sandersonfsl/diffbot_ws/media/eletronics_and_schematic.png

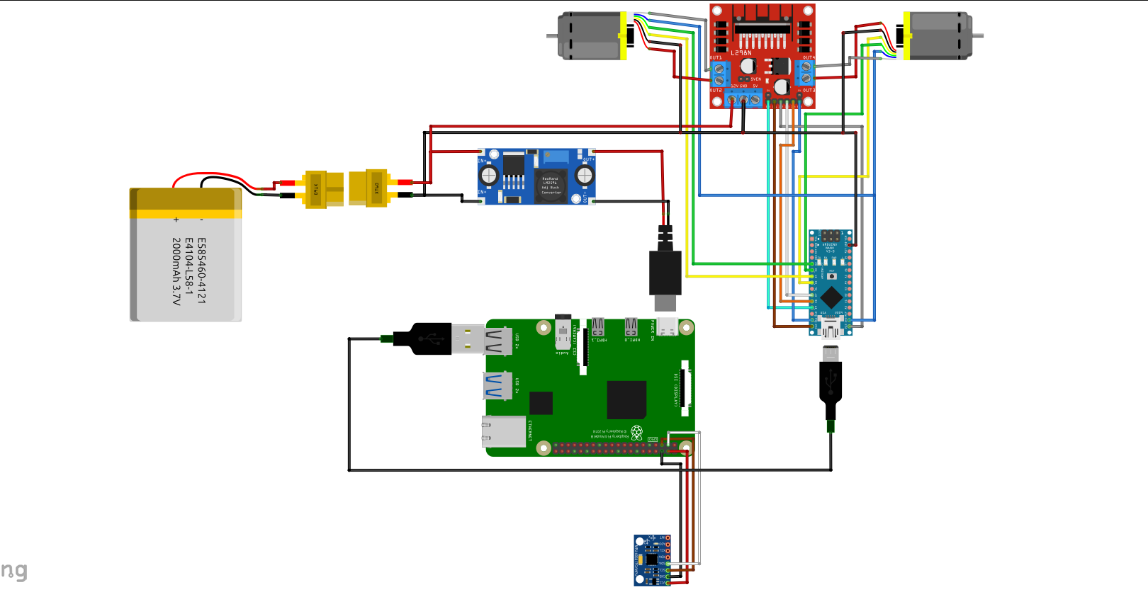
media/eletronics_and_schematic.png
