sandersonfsl/diffbot_ws/src/diffbot_description/meshes/laser_link.STL

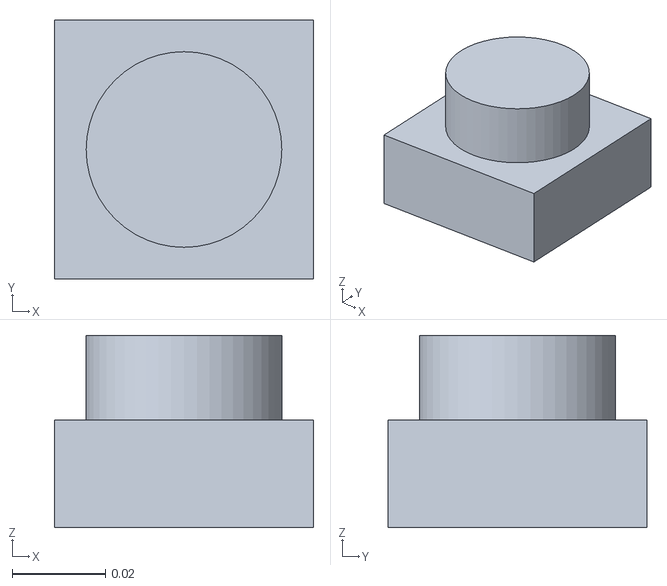
[picture p8: CAD file, 2026-09-09]
src/diffbot_description/meshes/laser_link.STL
0.0556 x 0.0556 x 0.0413
