sandersonfsl/diffbot_ws/src/diffbot_description/meshes/imu_link.STL

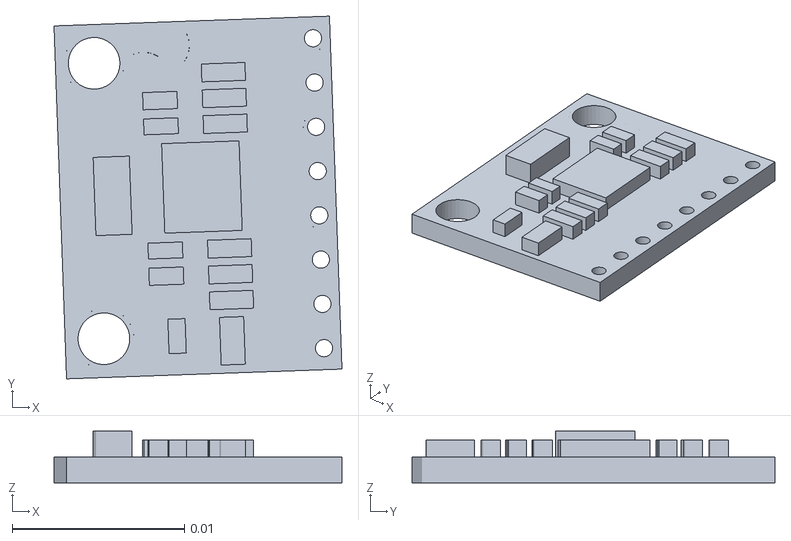
[picture p9: CAD file, 2026-08-24]
src/diffbot_description/meshes/imu_link.STL
0.0167 x 0.0211 x 0.003
