sandersonfsl/diffbot_ws/src/diffbot_description/meshes/caster_front_link.STL

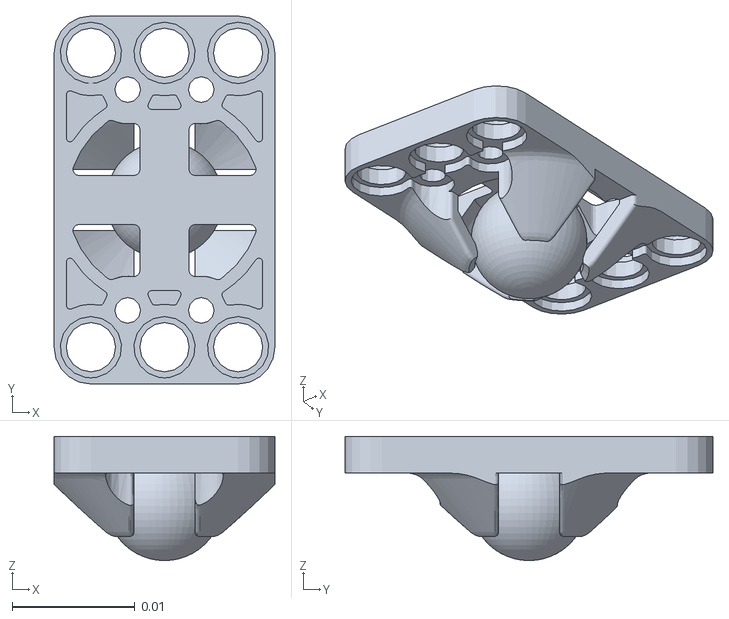
[picture p10: CAD file, 2026-08-19]
src/diffbot_description/meshes/caster_front_link.STL
0.018 x 0.03 x 0.0101
