sandersonfsl/diffbot_ws/src/diffbot_description/meshes/wheel_left_link.STL

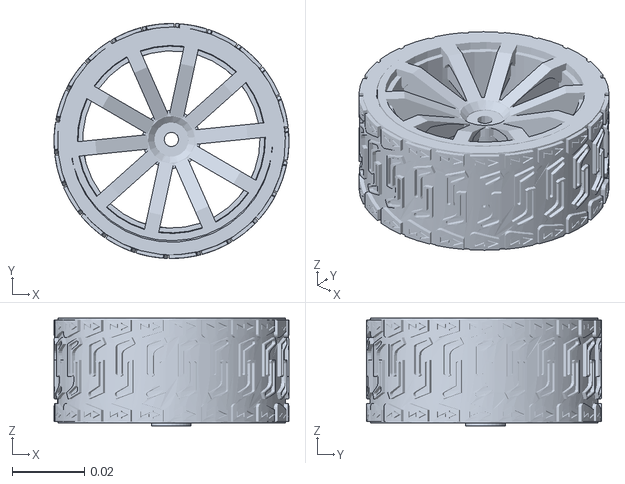
[picture p11: CAD file, 2026-08-19]
src/diffbot_description/meshes/wheel_left_link.STL
0.065 x 0.065 x 0.0298
