sandersonfsl/diffbot_ws/src/diffbot_description/meshes/base_link.STL

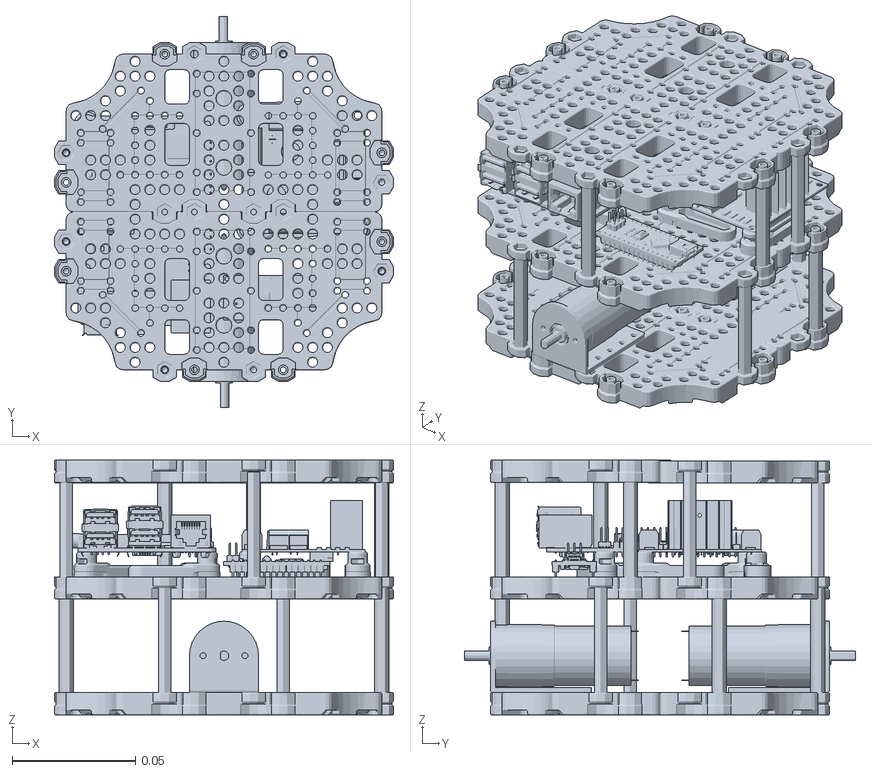
[picture p12: CAD file, 2026-08-13]
src/diffbot_description/meshes/base_link.STL
0.138 x 0.159 x 0.103
