sandersonfsl/diffbot_ws/(list of files, cad)

Other CAD files:
src/diffbot_description/meshes/caster_rear_link.STL
src/diffbot_description/meshes/wheel_right_link.STL
