sandersonfsl/diffbot_ws/docs/raspberry_pi_setup.md

# Raspberry Pi 5 (16GB) hardware setup

## OS

Ubuntu Server 24.04, installed directly (no desktop environment).

## SSH on a non-default port

SSH configured to listen on port `3333` instead of the default `22`.

## Networking — prioritize Wi-Fi over Ethernet

`/etc/netplan/50-cloud-init.yaml`, both interfaces configured with static IPs, Wi-Fi given a
lower (preferred) route metric than Ethernet so Wi-Fi wins whenever both are up:

```yaml
network:
  version: 2
  renderer: networkd
  ethernets:
    eth0:
      dhcp4: no
      addresses:
        - <YOUR_IP>/24
      routes:
        - to: default
          via: <YOUR_GATEWAY>
          metric: 100        # lower priority
      nameservers:
        addresses: [8.8.8.8, 1.1.1.1]
      optional: true
  wifis:
    wlan0:
      optional: true
      dhcp4: no
      addresses:
        - <YOUR_IP>/24
      routes:
        - to: default
          via: <YOUR_GATEWAY>
          metric: 50         # higher priority — Wi-Fi wins
      nameservers:
        addresses: [8.8.8.8, 1.1.1.1]
      access-points:
        "<YOUR_SSID>":
          password: "<YOUR_WIFI_PASSWORD>"
```

Apply with `sudo netplan apply`.

## Disable Wi-Fi power save (systemd service)

Wi-Fi power save causes dropped/laggy connections on a robot that needs a stable link for
teleop and ROS2 traffic. Disabled permanently via a oneshot systemd unit instead of a manual
`iw` call that wouldn't survive a reboot.

```sh
sudo apt update
sudo apt install iw
```

`/etc/systemd/system/wifi-powersave-off.service`:

```ini
[Unit]
Description=Disable WiFi power save
After=network-online.target
Wants=network-online.target

[Service]
Type=oneshot
ExecStart=/usr/sbin/iw dev wlan0 set power_save off
RemainAfterExit=true

[Install]
WantedBy=multi-user.target
```

```sh
sudo systemctl daemon-reload
sudo systemctl enable --now wifi-powersave-off.service
```

## Serial port permissions

Add the user to `dialout` so the Arduino's serial port doesn't need `sudo`:

```sh
sudo usermod -aG dialout $USER
```

Group membership only applies to new login sessions — log out/in (or `su - $USER`) to pick
it up without a full reboot.

## udev rules — stable serial device names (Arduino Nano, RPLIDAR C1)

Both the Nano and the RPLIDAR C1 show up as `/dev/ttyUSB*`, and which one gets
`ttyUSB0` vs `ttyUSB1` depends on USB enumeration order at boot — not safe to
hardcode. Identified each device's chip via:

```sh
udevadm info -a -n /dev/ttyUSB0 | grep -E "idVendor|idProduct|serial|product|manufacturer"
udevadm info -a -n /dev/ttyUSB1 | grep -E "idVendor|idProduct|serial|product|manufacturer"
```

Confirmed on this robot: Nano = CH340 clone (`1a86:7523`), RPLIDAR C1 = Silicon
Labs CP2102N (`10c4:ea60` — same chip/rule the `sllidar_ros2` package ships by
default). Different vendor:product pairs, so both rules coexist safely.

`/etc/udev/rules.d/99-arduino.rules`:

```
SUBSYSTEM=="tty", ATTRS{idVendor}=="1a86", ATTRS{idProduct}=="7523", MODE:="0666", SYMLINK+="arduino"
```

`/etc/udev/rules.d/99-rplidar.rules`:

```
SUBSYSTEM=="tty", ATTRS{idVendor}=="10c4", ATTRS{idProduct}=="ea60", MODE:="0666", SYMLINK+="rplidar"
```

```sh
sudo udevadm control --reload-rules
sudo udevadm trigger
ls -l /dev/arduino /dev/rplidar   # both should now point at the right ttyUSB*
```

`diffbot_description/urdf/diffbot_ros2_control.xacro` points at `/dev/arduino` for
this reason — don't revert it to a raw `ttyUSB0`/`ttyUSB1`.

## Bluetooth joystick (Logitech F710)

```sh
sudo apt update
sudo apt install bluez bluetooth
sudo systemctl enable --now bluetooth
```

Pair via `bluetoothctl`:

```
bluetoothctl
power on
agent on
default-agent
scan on
pair C6:F2:4D:3D:E1:CB
trust C6:F2:4D:3D:E1:CB
connect C6:F2:4D:3D:E1:CB
```

Verify the device shows up as an input device:

```sh
sudo apt install evtest
sudo evtest
```

If the connection is flaky/slow to reconnect, uncomment `FastConnectable = false` in
`/etc/bluetooth/main.conf`.

## udev rules — generic input devices

`/etc/udev/rules.d/81-event.rules`:

```
SUBSYSTEM=="input", KERNEL=="event*", GROUP="input", MODE="0660"
```

```sh
sudo udevadm control --reload-rules && sudo udevadm trigger
sudo usermod -aG input $USER   # new session needed to take effect
```

## udev rule — joystick device node

`/etc/udev/rules.d/99-joystick.rules`:

```
SUBSYSTEM=="input", KERNEL=="js*", GROUP="dialout", MODE="0666"
```

```sh
sudo udevadm control --reload-rules
sudo udevadm trigger
```

## Arduino firmware via PlatformIO (not the Arduino IDE)

Lets the Nano firmware be built/flashed from
the CLI, independent of the ROS 2 container, in its own project folder (kept separate from
the `diffbot_firmware` ROS2 package on purpose: one is the Nano-side sketch, the other is the
ROS2-side serial bridge — different build systems, different targets, no reason to couple them).

```sh
mkdir ~/platformio && cd ~/platformio
curl -fsSL -o get-platformio.py https://raw.githubusercontent.com/platformio/platformio-core-installer/master/get-platformio.py
sudo apt update && sudo apt install python3-venv
python3 get-platformio.py
```

Expose the CLI tools:

```sh
sudo mkdir -p /usr/local/bin
sudo ln -s ~/.platformio/penv/bin/platformio /usr/local/bin/platformio
sudo ln -s ~/.platformio/penv/bin/pio /usr/local/bin/pio
sudo ln -s ~/.platformio/penv/bin/piodebuggdb /usr/local/bin/piodebuggdb
pio --version   # sanity check
```

udev rules for PlatformIO's own upload tooling:

```sh
curl -fsSL https://raw.githubusercontent.com/platformio/platformio-core/develop/platformio/assets/system/99-platformio-udev.rules | sudo tee /etc/udev/rules.d/99-platformio-udev.rules
sudo udevadm control --reload-rules
sudo udevadm trigger
sudo service udev restart
```

The project itself lives in the repo at
[`diffbot_firmware_pio/`](../diffbot_firmware_pio/) — a sibling of `src/`, not a
colcon package, since it builds for the Arduino Nano, not for ROS 2. It's the
priority firmware path going forward, kept separate from the Arduino-IDE-style
sketch in `src/diffbot_firmware/firmware/` (same pins, same serial protocol —
just a different toolchain). `diffbot_firmware_pio/examples/` has smaller,
single-purpose sketches used while bringing the hardware up incrementally
(motor direction only, encoder reading only, ...) before the full
`src/main.cpp`; the wiring for the two most useful ones is diagrammed in
[`docs/schematics/simple_motor_control.png`](schematics/simple_motor_control.png)
and
[`docs/schematics/simple_encoder_reader.png`](schematics/simple_encoder_reader.png)
(same pin numbers as the sketches). The full build — battery, L298N, both
motors/encoders, Nano, Raspberry Pi, MPU6050 — is in
[`docs/schematics/diffbot_full_wiring.png`](schematics/diffbot_full_wiring.png).

```sh
pio boards nano   # confirms the board id: nanoatmega328
cd ~/development/diffbot_ws/diffbot_firmware_pio
pio run --target upload        # build + flash (uses default_envs in platformio.ini)
pio run -e nanoatmega328 -t upload   # explicit env, useful with multiple [env:...] blocks
pio run --target clean
pio device monitor             # serial monitor
```

## Docker (ROS 2 Humble container on the Pi)

Built from [`docker/Dockerfile`](../docker/Dockerfile). It intentionally does **not**
hardcode the ROS package list (that's how the old bumperbot image went stale once
Phase 2 — AMCL, SLAM, twist_mux, robot_localization, joy — was added): it ships only
base dev tools, and every actual ROS dependency gets pulled in afterwards via
`rosdep` against the real `package.xml` files in the mounted workspace.

```sh
cd ~/development/diffbot_ws/docker
docker build -t diffbot_humble .
```

```sh
docker run -dt \
  --name diffbot_humble \
  --restart always \
  --network host \
  --privileged \
  -v /dev:/dev \
  -v ~/development:/development \
  diffbot_humble
```

First time (or whenever a package.xml gains a new dependency):

```sh
docker exec -it diffbot_humble /bin/bash
cd /development/diffbot_ws
rosdep update
rosdep install --from-paths src --ignore-src -r -y
```

Day to day:

```sh
docker exec -it diffbot_humble /bin/bash   # re-enter
docker start diffbot_humble               # restart if exited
```

## MPU6050 IMU — I2C setup

`i2c-tools`, `libi2c-dev`, `python3-smbus` come in automatically via the
`rosdep install` step above (declared in `diffbot_firmware/package.xml`); the
Dockerfile only adds `smbus2` directly, since nothing in `mpu6050_driver.py`
actually imports it today (it imports `smbus`) — kept installed in case that
changes, not currently load-bearing.
