sandersonfsl/diffbot_ws/(list of files, drawings)

Other design files:
docs/schematics/diffbot_full_wiring.fzz
