sandersonfsl/diffbot_ws/diffbot_firmware_pio/examples/simple_serial_receiver.cpp

#include <Arduino.h>

#define LED_PIN 13

void setup() {
  pinMode(LED_PIN, OUTPUT);
  digitalWrite(LED_PIN, LOW);

  Serial.begin(115200);
  Serial.setTimeout(1);
}

void loop() {
  if (Serial.available())
  {

    int x = Serial.readString().toInt();

    if(x == 0)
    {
      digitalWrite(LED_PIN, LOW);
    }
    else
    {
      digitalWrite(LED_PIN, HIGH);
    }
  }

  delay(1);
}
