sandersonfsl/diffbot_ws/(commit log)

2026-08-13 add robot description package
    [base_link.STL, diffbot.urdf.xacro, wheel_right_link.STL]
2026-08-19 add robot description display launch and rviz config
    [caster_front_link.STL, caster_rear_link.STL, diffbot.urdf.xacro, wheel_left_link.STL]
2026-08-20 add robot gazebo launch with materials
    [diffbot.urdf.xacro, diffbot_gazebo.xacro, diffbot_material.xacro]
2026-08-20 implement ros2 control setup
    [diffbot.urdf.xacro, diffbot_controllers.yaml, diffbot_gazebo.xacro, diffbot_ros2_control.xacro]
2026-08-20 add differential kinematics control, diff_drive_controller path, and joystick teleop
    [diffbot_controllers.yaml]
2026-08-22 update dependencies section
    [diffbot.urdf.xacro]
2026-08-23 create odometry
2026-08-24 create simulated noisy odometry
    [diffbot.urdf.xacro, diffbot_gazebo.xacro, imu_link.STL]
2026-08-25 add diffbot_localization package with EKF sensor fusion (robot_localization) and IMU republisher
2026-09-08 add diffbot_firmware and diffbot_bringup packages for real hardware support and media
    [diffbot.urdf.xacro, diffbot_controllers.yaml, diffbot_ros2_control.xacro]
2026-09-09 add RPLIDAR C1 2D LiDAR to diffbot
    [diffbot.urdf.xacro, diffbot_gazebo.xacro, laser_link.STL]
2026-09-09 adjust material urdf and laser mesh
    [diffbot.urdf.xacro, diffbot_material.xacro, laser_link.STL]
2026-09-14 add diffbot_utils package with LiDAR-based safety_stop
2026-10-27 add AMCL particle filter localization
2026-10-28 add SLAM via slam_toolbox, wired into bringup with use_slam
2026-10-29 add Raspberry Pi hardware setup docs
2026-10-29 add PlatformIO firmware project, repo-tracked Dockerfile, and wiring schematics for the real robot
2026-10-29 add stable udev symlinks for Arduino/RPLIDAR and point xacro at /dev/arduino
2026-10-29 Wire AMCL/SLAM into real robot bringup via use_slam
